LithosphereRocketry/sharkbait-tracker/README.md

# sharkbait-tracker
A small and low-cost GPS tracker for model rocketry applications.
