LithosphereRocketry/sharkbait-tracker/hardware/sharkbait-tracker/sharkbait-tracker.kicad_pcb

## KiCad design hardware/sharkbait-tracker/sharkbait-tracker.kicad_pcb (2025-06-09)

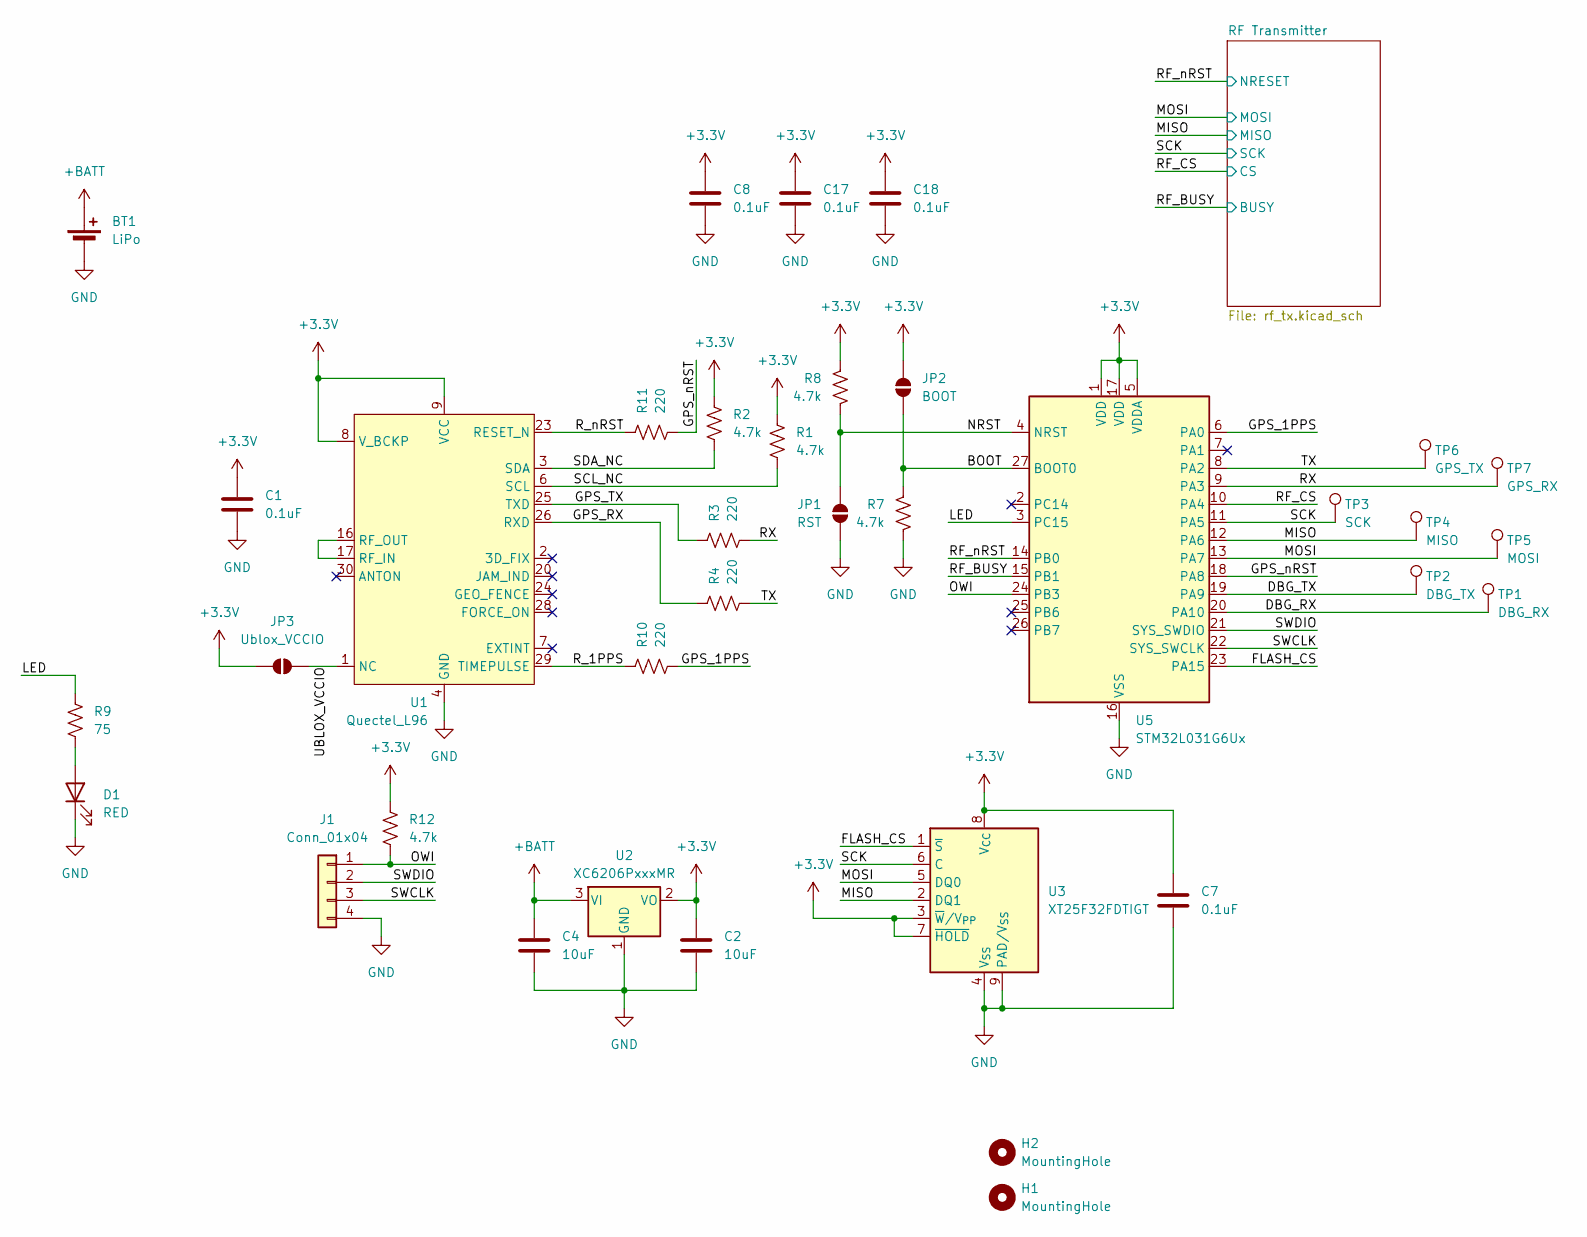
[picture p1: schematic sharkbait-tracker.kicad_sch]

Parts:
BT1: LiPo; PinHeader_1x02_P2.00mm_Vertical; JLCPCB_IGNORE ignore
C1, C7, C8, C17, C18: 0.1uF; C_0402_1005Metric; LCSC C1525
C2, C4: 10uF; C_0603_1608Metric; LCSC C19702
D1: RED; LED_0603_1608Metric; LCSC C2286
H1, H2: MountingHole; MountingHole_2.2mm_M2
J1: Conn_01x04; Molex_PicoBlade_53047-0410_1x04_P1.25mm_Vertical; JLCPCB_IGNORE ignore
JP1: RST; SolderJumper-2_P1.3mm_Open_RoundedPad1.0x1.5mm
JP2: BOOT; SolderJumper-2_P1.3mm_Open_RoundedPad1.0x1.5mm
JP3: Ublox_VCCIO; SolderJumper-2_P1.3mm_Open_TrianglePad1.0x1.5mm
R1, R2, R7, R8, R12: 4.7k; R_0402_1005Metric; LCSC C25900
R3, R4, R10, R11: 220; R_0402_1005Metric; LCSC C25091
R9: 75; R_0402_1005Metric; LCSC C25133
TP1: DBG_RX; TestPoint_Pad_D1.0mm
TP2: DBG_TX; TestPoint_Pad_D1.0mm
TP3: SCK; TestPoint_Pad_D1.0mm
TP4: MISO; TestPoint_Pad_D1.0mm
TP5: MOSI; TestPoint_Pad_D1.0mm
TP6: GPS_TX; TestPoint_Pad_D1.0mm
TP7: GPS_RX; TestPoint_Pad_D1.0mm
U1: Quectel_L96; CAM-M8_QuectelL96; LCSC C5197298
U2: XC6206PxxxMR; SOT-23-3; LCSC C5446
U3: XT25F32FDTIGT; Winbond_USON-8-1EP_3x2mm_P0.5mm_EP0.2x1.6mm; LCSC C7429719
U5: STM32L031G6Ux; QFN-28_4x4mm_P0.5mm; LCSC C96514

Connections:
+3.3V: C1.1, C2.1, C7.1, C8.1, C17.1, C18.1, JP2.2 (B), JP3.1 (A), R1.1, R2.1, R8.1, R12.1, U1.8 (V_BCKP), U1.9 (VCC), U2.2 (VO), U3.3 (~W/V_{PP}), U3.7 (~HOLD), U3.8 (V_{CC}), U5.1 (VDD), U5.5 (VDDA), U5.17 (VDD); also elsewhere on the board
+BATT: BT1.1 (+), C4.1, U2.3 (VI)
/BOOT: JP2.1 (A), R7.1, U5.27 (BOOT0)
/DBG_RX: TP1.1, U5.20 (PA10)
/DBG_TX: TP2.1, U5.19 (PA9)
/FLASH_CS: U3.1 (~S), U5.23 (PA15)
/GPS_1PPS: R10.2, U5.6 (PA0)
/GPS_RX: R4.1, U1.26 (RXD)
/GPS_TX: R3.1, U1.25 (TXD)
/GPS_nRST: R11.2, U5.18 (PA8)
/LED: R9.2, U5.3 (PC15)
/MISO: TP4.1, U3.2 (DQ1), U5.12 (PA6); also elsewhere on the board
/MOSI: TP5.1, U3.5 (DQ0), U5.13 (PA7); also elsewhere on the board
/NRST: JP1.2 (B), R8.2, U5.4 (NRST)
/OWI: J1.1, R12.2, U5.24 (PB3)
/RF_BUSY: U5.15 (PB1); also elsewhere on the board
/RF_CS: U5.10 (PA4); also elsewhere on the board
/RF_nRST: U5.14 (PB0); also elsewhere on the board
/RX: R3.2, TP7.1, U5.9 (PA3)
/R_1PPS: R10.1, U1.29 (TIMEPULSE)
/R_nRST: R11.1, U1.23 (RESET_N)
/SCK: TP3.1, U3.6 (C), U5.11 (PA5); also elsewhere on the board
/SCL_NC: R1.2, U1.6 (SCL)
/SDA_NC: R2.2, U1.3 (SDA)
/SWCLK: J1.3, U5.22 (SYS_SWCLK)
/SWDIO: J1.2, U5.21 (SYS_SWDIO)
/TX: R4.2, TP6.1, U5.8 (PA2)
/UBLOX_VCCIO: JP3.2 (B), U1.1 (NC)
GND: BT1.2 (-), C1.2, C2.2, C4.2, C7.2, C8.2, C17.2, C18.2, D1.1 (K), J1.4, JP1.1 (A), R7.2, U1.4 (GND), U1.5 (GND), U1.10 (GND), U1.11 (GND), U1.12 (GND), U1.13 (GND), U1.14 (GND), U1.15 (GND), U1.18 (GND), U1.19 (GND), U1.21 (GND), U1.22 (GND), U1.27 (GND), U1.31 (GND), U2.1 (GND), U3.4 (V_{SS}), U3.9 (PAD/V_{SS}), U5.16 (VSS), U5.28 (VSS); also elsewhere on the board
unnamed: D1.2 (A), R9.1
unnamed: U1.16 (RF_OUT), U1.17 (RF_IN)

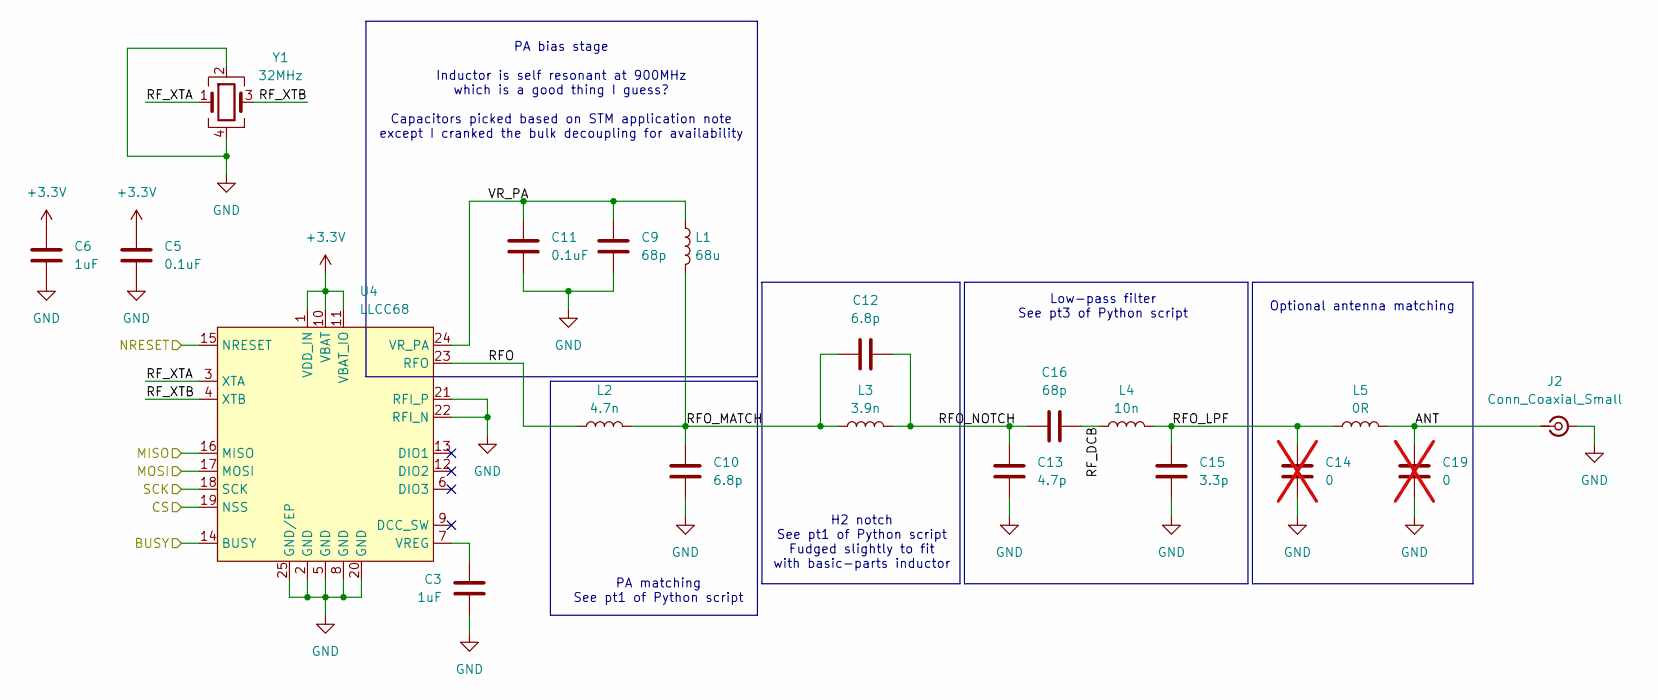
[picture p2: schematic rf_tx.kicad_sch]

Parts:
C3, C6: 1uF; C_0402_1005Metric; LCSC C52923
C5, C11: 0.1uF; C_0402_1005Metric; LCSC C1525
C9, C16: 68p; C_0402_1005Metric; LCSC C14441
C10, C12: 6.8p; C_0402_1005Metric; LCSC C1576
C13: 4.7p; C_0402_1005Metric; LCSC C1569
C14, C19: 0; C_0402_1005Metric; LCSC C1565; not fitted
C15: 3.3p; C_0402_1005Metric; LCSC C1565
J2: Conn_Coaxial_Small; SMA_Samtec_SMA-J-P-H-ST-EM1_EdgeMount_WireWhip; JLCPCB_IGNORE ignore
L1: 68u; L_0603_1608Metric; LCSC C13415
L2: 4.7n; L_0402_1005Metric; LCSC C13595
L3: 3.9n; L_0402_1005Metric; LCSC C14033
L4: 10n; L_0402_1005Metric; LCSC C27147
L5: 0R; L_0402_1005Metric; LCSC C17168
U4: LLCC68; QFN-24-1EP_4x4mm_P0.5mm_EP2.7x2.7mm_ThermalVias; LCSC C5120261
Y1: 32MHz; Crystal_SMD_2016-4Pin_2.0x1.6mm; LCSC C843260

Connections:
+3.3V: C5.1, C6.1, U4.1 (VDD_IN), U4.10 (VBAT), U4.11 (VBAT_IO); also elsewhere on the board
/MISO: U4.16 (MISO); also elsewhere on the board
/MOSI: U4.17 (MOSI); also elsewhere on the board
/RF Transmitter/ANT: C19.1, J2.1 (In), L5.2
/RF Transmitter/RFO: L2.1, U4.23 (RFO)
/RF Transmitter/RFO_LPF: C14.1, C15.1, L4.2, L5.1
/RF Transmitter/RFO_MATCH: C10.1, C12.1, L1.2, L2.2, L3.1
/RF Transmitter/RFO_NOTCH: C12.2, C13.1, C16.1, L3.2
/RF Transmitter/RF_DCB: C16.2, L4.1
/RF Transmitter/RF_XTA: U4.3 (XTA), Y1.1
/RF Transmitter/RF_XTB: U4.4 (XTB), Y1.3
/RF Transmitter/VR_PA: C9.1, C11.1, L1.1, U4.24 (VR_PA)
/RF_BUSY: U4.14 (BUSY); also elsewhere on the board
/RF_CS: U4.19 (NSS); also elsewhere on the board
/RF_nRST: U4.15 (NRESET); also elsewhere on the board
/SCK: U4.18 (SCK); also elsewhere on the board
GND: C3.2, C5.2, C6.2, C9.2, C10.2, C11.2, C13.2, C14.2, C15.2, C19.2, J2.2 (Ext), U4.2 (GND), U4.5 (GND), U4.8 (GND), U4.20 (GND), U4.21 (RFI_P), U4.22 (RFI_N), U4.25 (GND/EP), Y1.2, Y1.4; also elsewhere on the board
unnamed: C3.1, U4.7 (VREG)

Notes on the sheet:
PA bias stage Inductor is self resonant at 900MHz which is a good thing I guess? Capacitors picked based on STM application note except I cranked the bulk decoupling for availability
Optional antenna matching
Low-pass filter See pt3 of Python script
PA matching See pt1 of Python script
H2 notch See pt1 of Python script Fudged slightly to fit with basic-parts inductor

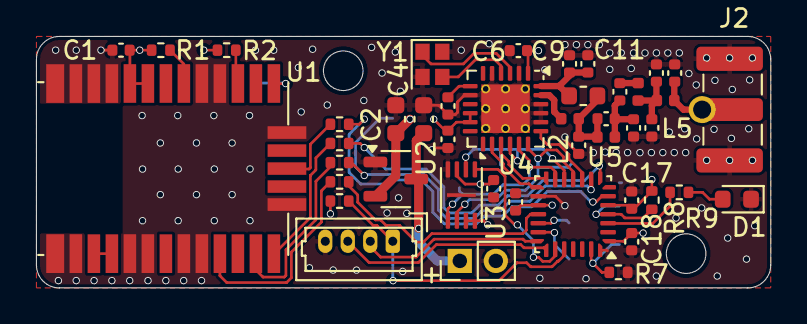
[picture p3: board sharkbait-tracker.kicad_pcb from above]

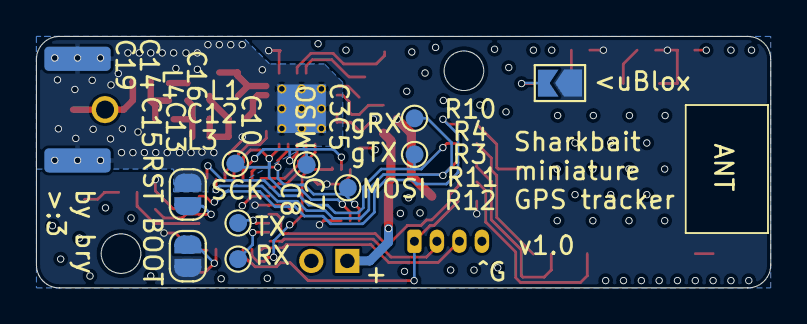
[picture p4: board sharkbait-tracker.kicad_pcb from below]

Board: 4 copper layers, 40.8 x 14.0 mm, 56 parts (10 on the bottom side), 41 nets.
