LithosphereRocketry/sharkbait-tracker/(commit log)

2025-01-17 Losing my soul to dark RF magic
    [sharkbait-tracker.kicad_pcb, sharkbait-tracker.kicad_sch]
2025-01-21 Most of the layout done, but might break things
    [rf_tx.kicad_sch, sharkbait-tracker.kicad_pcb, sharkbait-tracker.kicad_sch]
2025-01-21 Everything fits, might rearrange a little
    [sharkbait-tracker.kicad_pcb, sharkbait-tracker.kicad_sch]
2025-01-22 Removed battery voltage divider again, and rounded corners
    [sharkbait-tracker.kicad_pcb, sharkbait-tracker.kicad_sch]
2025-01-23 Combination antenna footprint and build automation
    [rf_tx.kicad_sch, sharkbait-tracker.kicad_pcb, sharkbait-tracker.kicad_sch]
2025-01-26 Widened RF PA traces a smidge
    [sharkbait-tracker.kicad_pcb]
2025-06-09 Updated vias for easier tolerances
    [sharkbait-tracker.kicad_pcb, sharkbait-tracker.kicad_sch]
2025-06-09 Narrowed pads to match ublox footprint (the quectel one is extra wide for some reason
